ideo/eyeo-flower/PCB/EYEO_Flower3_Sch-01.png

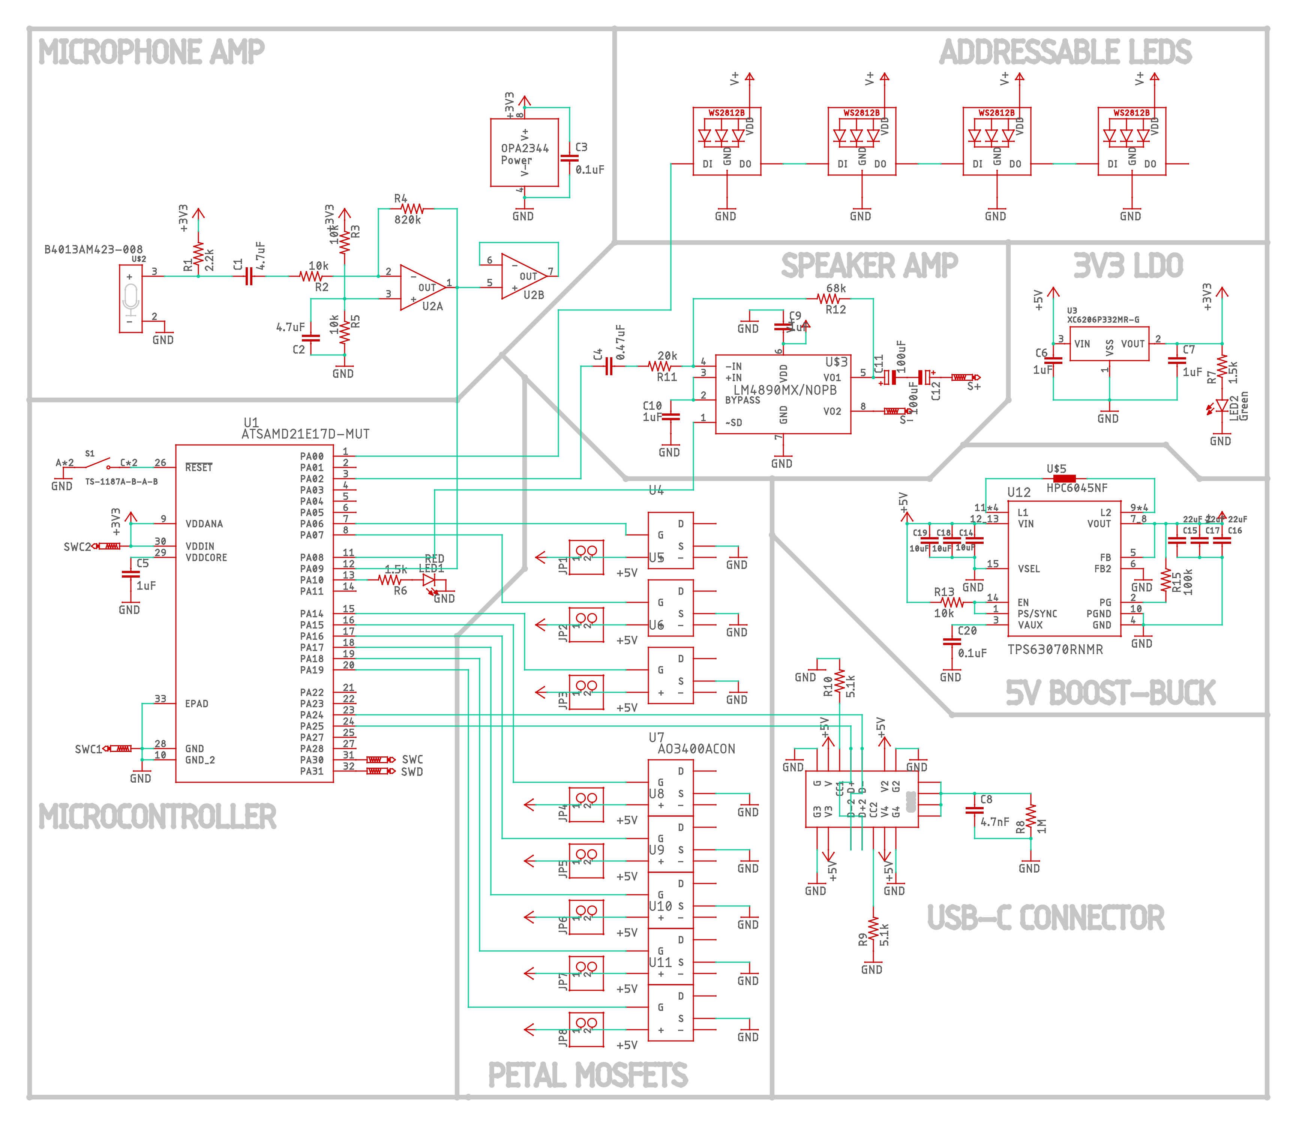
PCB/EYEO_Flower3_Sch-01.png
