ideo/eyeo-flower/PCB/EYEO_Flower3.brd

## EAGLE design PCB/EYEO_Flower3.brd (2022-10-28)

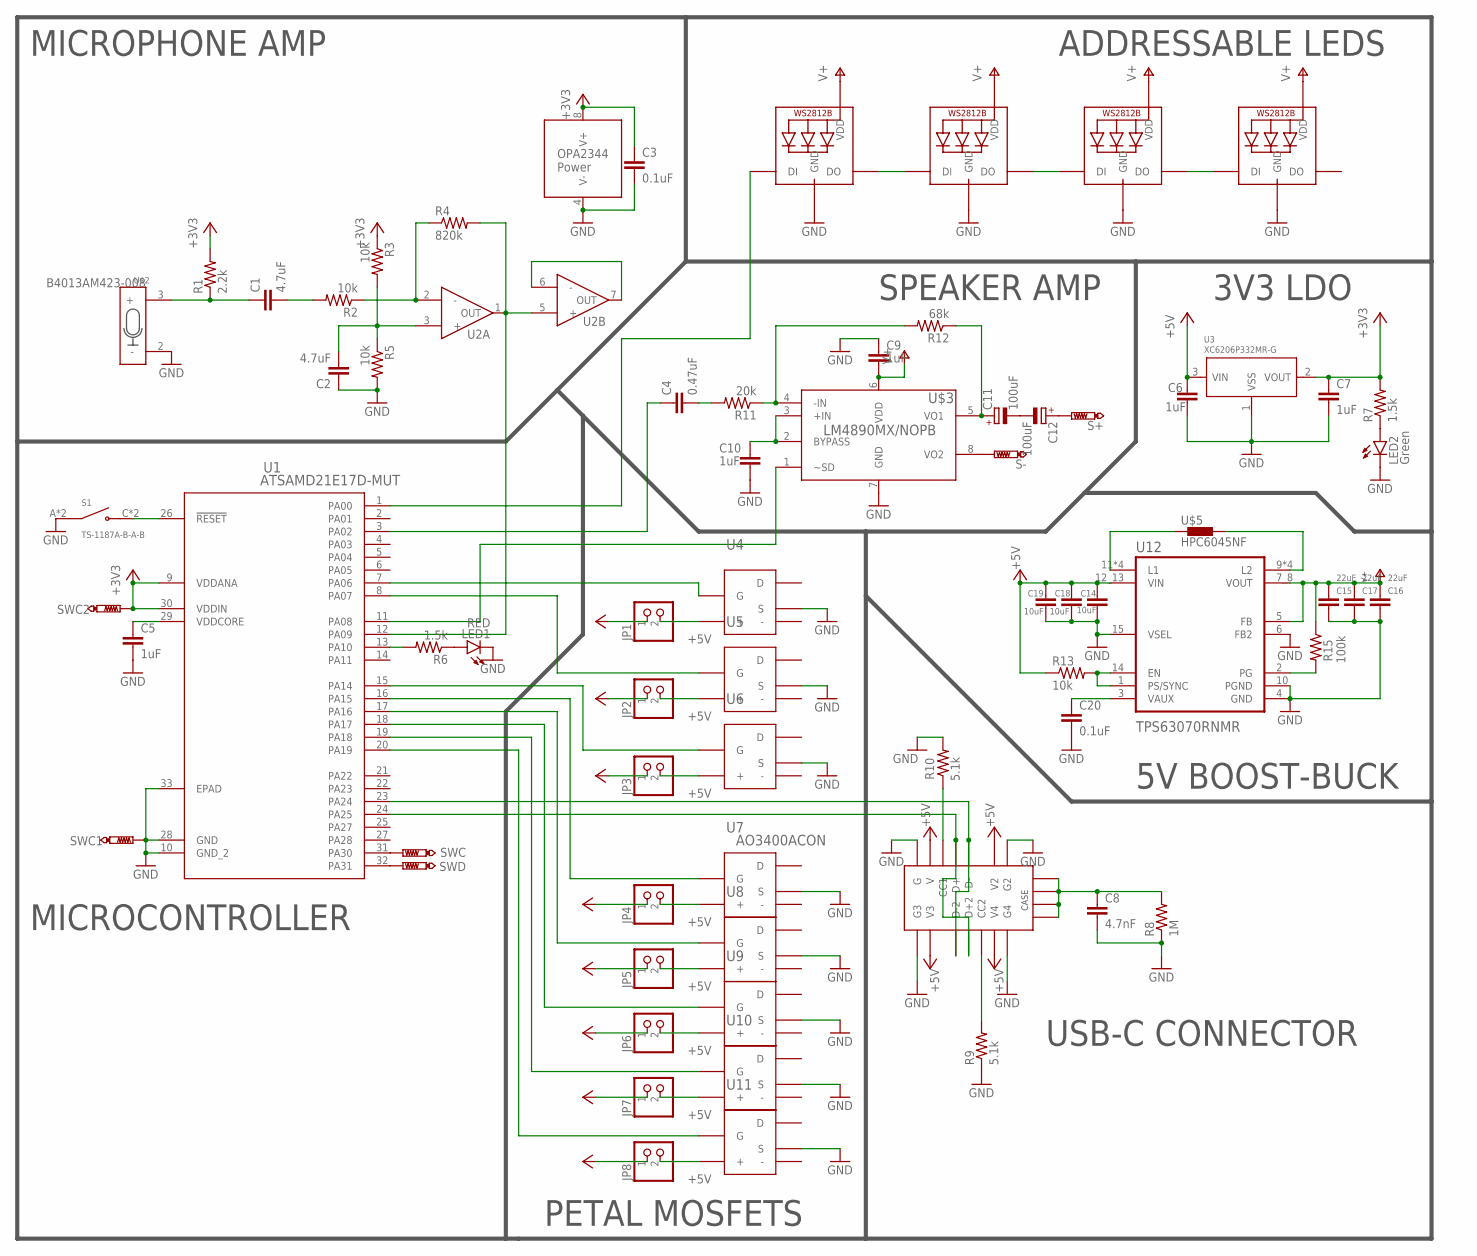
[picture p2: schematic EYEO_Flower3.sch]

Parts:
C1, C2: 4.7uF; C0603; LCSC_PART C19666
C3, C20: 0.1uF; C0402; LCSC_PART C307331
C4: 0.47uF; C0603; LCSC_PART C1623
C5, C6, C7, C9, C10: 1uF; C0603; LCSC_PART C15849
C8: 4.7nF; C0402; LCSC_PART C1538
C11, C12: 100uF; 153CLV-0505; LCSC_PART C3347
C14, C18, C19: 10uF; C0603; LCSC_PART C96446
C15, C16, C17: 22uF; C0603; LCSC_PART C59461
JP1, JP2, JP3, JP4, JP5, JP6, JP7, JP8: PINHD-1X2; 1X02; LCSC_PART C2889984
LED1: RED; CHIPLED_0805; LCSC_PART C84256
LED2: Green; CHIPLED_0603; LCSC_PART C72043
LED3, LED4, LED5, LED6: WS2812B5050; WS2812B
R1: 2.2k; R0402; LCSC_PART C25879
R2, R3, R5, R13: 10k; R0402; LCSC_PART C25744
R4: 820k; R0402; LCSC_PART C67558
R6, R7: 1.5k; R0402; LCSC_PART C25867
R8: 1M; R0402; LCSC_PART C26083
R9, R10: 5.1k; R0402; LCSC_PART C25905
R11: 20k; R0402; LCSC_PART C25765
R12: 68k; R0402; LCSC_PART C36871
R15: 100k; R0402; LCSC_PART C25741
S1: TS-1187A-B-A-B; SW_TS-1187A-B-A-B; LCSC_PART C318884
S+: PTR11MM; 1MM; LCSC_PART C238122
S-: PTR11MM; 1MM; LCSC_PART C238122
SWC, SWC1, SWC2: PTR1PAD1-13; P1-13
SWD: PTR1PAD1-13; P1-13
U1: ATSAMD21E17D-MUT; QFN32_5X5MC_MCH
U2: OPA2344UA; D8; LCSC_PART C202213
U3: XC6206P332MR-G; SOT-23; LCSC_PART C5446
U4, U5, U6, U7, U8, U9, U10, U11: AO3400ACON; SOT23-BCE-CON; LCSC_PART C20917
U12: TPS63070RNMR; VREG_TPS63070RNMR
U$1: USB-C; 918-418K2022Y40000; LCSC_PART C168704
U$2: B4013AM423; LCSC_PART C233794
U$3: LM4890MX/NOPB; M08A; LCSC_PART C117476
U$5: HPC6045NF

Connections:
+3V3: C3.1, C7.1, R1.2, R3.1, R7.2, SWC2.TP, U1.9 (VDDANA), U1.30 (VDDIN), U2.8 (V+), U3.2 (VOUT)
+5V: C6.1, C14.1, C18.1, C19.1, JP1.1, JP2.1, JP3.1, JP4.1, JP5.1, JP6.1, JP7.1, JP8.1, R13.1, U3.3 (VIN), U12.12_13 (VIN), U$1.V, U$1.V2, U$1.V3, U$1.V4
GND: C2.1, C3.2, C5.2, C6.2, C7.2, C8.2, C9.1, C10.2, C14.2, C15.2, C16.2, C17.2, C18.2, C19.2, C20.2, LED1.C, LED2.C, LED3.3-GND (GND), LED4.3-GND (GND), LED5.3-GND (GND), LED6.3-GND (GND), R5.2, R8.1, R9.1, R10.2, S1.A (COM), S1.B (COM), SWC1.TP, U1.10 (GND_2), U1.28 (GND), U1.33 (EPAD), U2.4 (V-), U3.1 (VSS), U4.S, U5.S, U6.S, U7.S, U8.S, U9.S, U10.S, U11.S, U12.4 (GND), U12.6 (FB2), U12.10 (PGND), U12.15 (VSEL), U$1.G, U$1.G2, U$1.G3, U$1.G4, U$2.2 (-), U$3.7 (GND)
unnamed: LED1.A, R6.1
unnamed: S1.C (NO), S1.D (NO), U1.26 (!RESET)
unnamed: LED2.A, R7.1
unnamed: C5.1, U1.29 (VDDCORE)
unnamed: C8.1, R8.2, U$1.OG1 (1), U$1.OG2 (2), U$1.OG3 (3), U$1.OG4 (4)
unnamed: R6.2, U1.13 (PA10)
unnamed: U1.23 (PA24), U$1.D-, U$1.D-2
unnamed: U1.24 (PA25), U$1.D+, U$1.D+2
unnamed: SWC.TP, U1.31 (PA30)
unnamed: SWD.TP, U1.32 (PA31)
unnamed: R4.2, U1.12 (PA09), U2.1 (OUT), U2.5 (+)
unnamed: R2.1, R4.1, U2.2 (-)
unnamed: R10.1, U$1.CC1
unnamed: R9.2, U$1.CC2
unnamed: C2.2, R3.2, R5.1, U2.3 (+)
unnamed: C1.2, R2.2
unnamed: C1.1, R1.1, U$2.3 (+)
unnamed: U2.6 (-), U2.7 (OUT)
unnamed: C4.1, U1.3 (PA02)
unnamed: C4.2, R11.2
unnamed: R11.1, R12.2, U$3.4 (-IN)
unnamed: C11.-, C12.-
unnamed: C10.1, U$3.2 (BYPASS), U$3.3 (+IN)
unnamed: C11.+, R12.1, U$3.5 (VO1)
unnamed: U1.11 (PA08), U$3.1 (~SD)
unnamed: S-.TP, U$3.8 (VO2)
unnamed: U1.7 (PA06), U4.G
unnamed: U1.8 (PA07), U5.G
unnamed: U1.15 (PA14), U6.G
unnamed: U1.16 (PA15), U7.G
unnamed: U1.17 (PA16), U8.G
unnamed: U1.18 (PA17), U9.G
unnamed: U1.19 (PA18), U10.G
unnamed: U1.20 (PA19), U11.G
unnamed: LED3.4-DIN (DI), U1.1 (PA00)
unnamed: LED3.2-DOUT (DO), LED4.4-DIN (DI)
unnamed: LED4.2-DOUT (DO), LED5.4-DIN (DI)
unnamed: LED5.2-DOUT (DO), LED6.4-DIN (DI)
unnamed: C12.+, S+.TP
unnamed: JP1.2, U4.+
unnamed: JP2.2, U5.+
unnamed: JP3.2, U6.+
unnamed: JP4.2, U7.+
unnamed: JP5.2, U8.+
unnamed: JP6.2, U9.+
unnamed: JP7.2, U10.+
unnamed: JP8.2, U11.+
unnamed: R13.2, U12.1 (PS/SYNC), U12.14 (EN)
unnamed: U12.11 (L1), U12.11_1 (L1), U12.11_2 (L1), U12.11_3 (L1), U$5.P$1 (1)
unnamed: C20.1, U12.3 (VAUX)
unnamed: U12.9 (L2), U12.9_1 (L2), U12.9_2 (L2), U12.9_3 (L2), U$5.P$2 (2)
unnamed: R15.2, U12.2 (PG)
V+: C9.2, C15.1, C16.1, C17.1, LED3.1-VDD (VDD), LED4.1-VDD (VDD), LED5.1-VDD (VDD), LED6.1-VDD (VDD), R15.1, U12.5 (FB), U12.7_8 (VOUT), U$3.6 (VDD)

Notes on the sheet:
MICROCONTROLLER
PETAL MOSFETS
USB-C CONNECTOR
5V BOOST-BUCK
3V3 LDO
SPEAKER AMP
ADDRESSABLE LEDS
MICROPHONE AMP

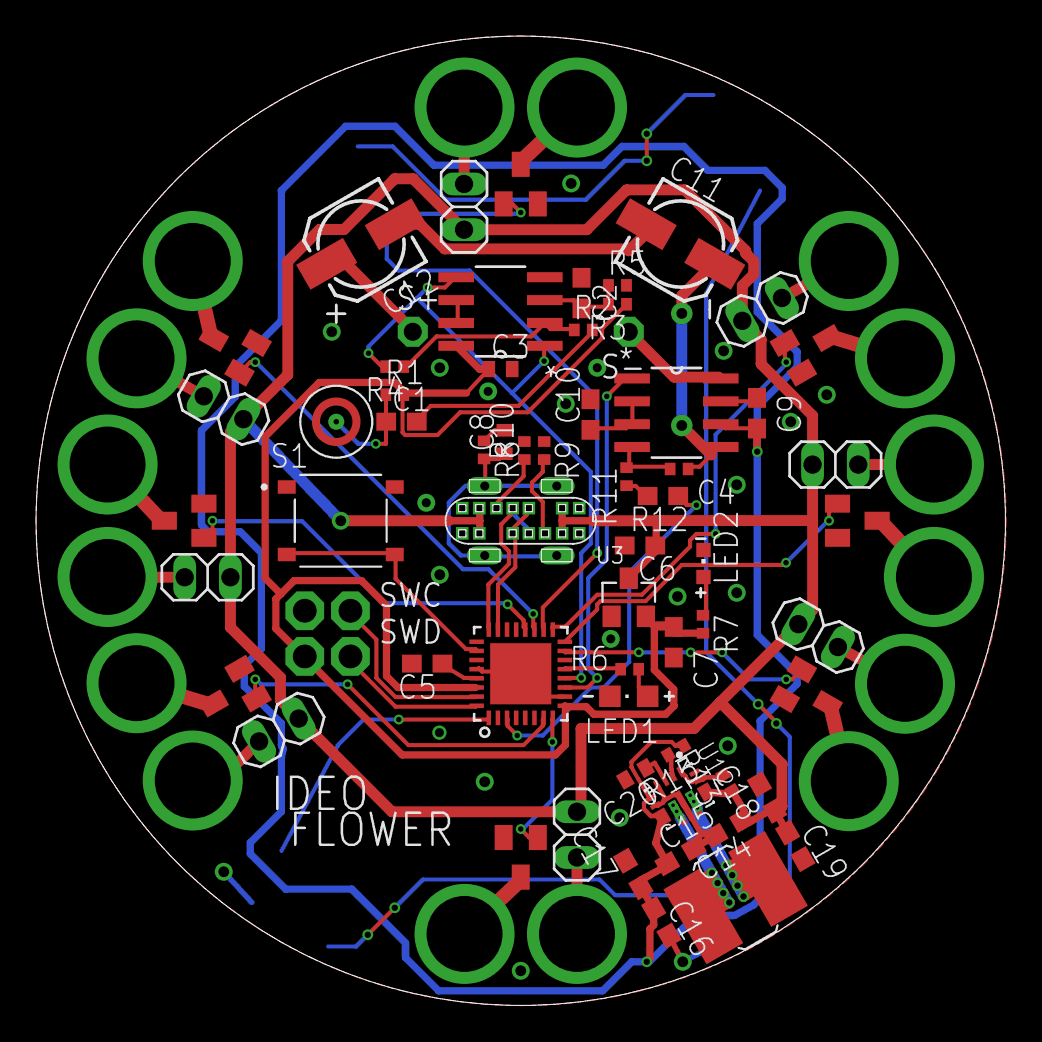
[picture p3: board EYEO_Flower3.brd from above]

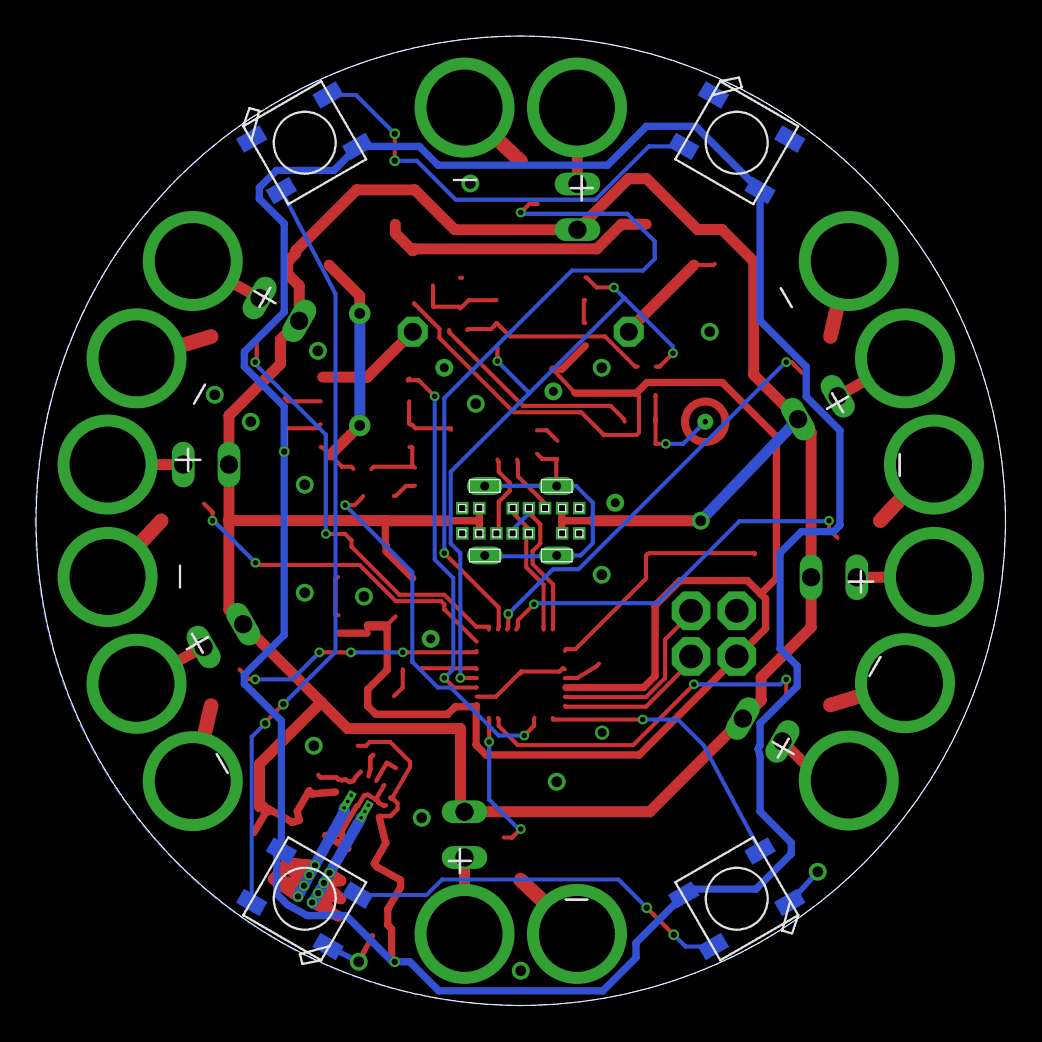
[picture p4: board EYEO_Flower3.brd from below]

Board: 2 copper layers, 53.9 x 53.9 mm, 70 parts (4 on the bottom side), 56 nets.
