ideo/eyeo-flower/(commit log)

2022-09-30 Adding Board Files
    Added PCB Files
    [EYEO_Flower3.brd, EYEO_Flower3.sch, EYEO_Flower3_top_bom.csv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]
2022-10-28 Reorganized, added bootloader
    Reorganized folder structure, added bootloader
    [EYEO_Flower3.brd, EYEO_Flower3.sch, EYEO_Flower3_Sch.brd, EYEO_Flower3_Sch.sch, EYEO_Flower3_top_bom.csv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]
2022-11-02 Labeling nets for programmer
    [EYEO_Flower3.sch]
